Iceteavanill/MicroManipulatorStepper/electronics/control_board/production/ControlBoard_v1.csv

Reference | Qty | Value | Footprint | Datasheet | Distributor | Distributor Number
A1 | 1 | RaspberryPi_Pico | Module:RaspberryPi_Pico_Common_Unspecified | https://datasheets.raspberrypi.com/pico/pico-datasheet.pdf | Digikey | 2648-SC0918CT-ND
C1,C7-C10,C14-C17,C21-C24 | 13 | 0.1u | Capacitor_SMD:C_0603_1608Metric_Pad1.08x0.95mm_HandSolder |  | Digikey | 399-C0603C104M5RACTUCT-ND
C2-C4 | 3 | 22u | Capacitor_SMD:C_0805_2012Metric_Pad1.18x1.45mm_HandSolder |  | Digikey | 490-10749-1-ND
C5 | 1 | 1u | Capacitor_SMD:C_0805_2012Metric_Pad1.18x1.45mm_HandSolder |  | Digikey | 1276-6469-1-ND
C6,C11,C13,C18,C20,C25 | 6 | 10u | Capacitor_SMD:C_0805_2012Metric_Pad1.18x1.45mm_HandSolder |  | Digikey | 490-10502-1-ND
C12,C19,C26 | 3 | 100u | Capacitor_THT:CP_Radial_D6.3mm_P2.50mm |  | Digikey | 399-A7C0EB107M1EAAS065-ND
D1 | 1 | 1N5819 | Diode_THT:D_DO-41_SOD81_P10.16mm_Horizontal | http://www.vishay.com/docs/88525/1n5817.pdf | Digikey | 1801-1N5819CT-ND
D2 | 1 | PMEG4010 | Diode_SMD:D_SOD-123F | https://assets.nexperia.com/documents/data-sheet/PMEG4010CEH_PMEG4010CEJ.pdf | Digikey | -
D3 | 1 | SMAJ12CA | Diode_SMD:D_SMA_Handsoldering | https://www.diodes.com/assets/Datasheets/SMAJ5.0CA-SMAJ200CA.pdf | Digikey | SMAJ12CALFCT-ND
D4 | 1 | 12V_OK | LED_SMD:LED_0805_2012Metric_Pad1.15x1.40mm_HandSolder |  | ? | -
D5 | 1 | 5V_OK | LED_SMD:LED_0805_2012Metric_Pad1.15x1.40mm_HandSolder |  | ? | -
D6 | 1 | 3V3_OK | LED_SMD:LED_0805_2012Metric_Pad1.15x1.40mm_HandSolder |  | ? | -
F1 | 1 | 7A | Fuse:Fuse_1206_3216Metric_Pad1.42x1.75mm_HandSolder |  | Digikey | 5923-0685T7000-01CT-ND
J1 | 1 | Power | Connector_AMASS:AMASS_XT60-M_1x02_P7.20mm_Vertical |  | Digikey | 1738-1437-ND
J2,J4,J5 | 3 | Conn_01x06_Pin | Connector_JST:JST_PH_B6B-PH-K_1x06_P2.00mm_Vertical |  | Digikey | 455-B6B-XH-A-ND
J3 | 1 | Barrel_Jack_Switch | Connector_BarrelJack:BarrelJack_Horizontal |  | Digikey | 839-54-00166-ND
J6 | 1 | I2C | Connector_JST:JST_PH_B4B-PH-K_1x04_P2.00mm_Vertical |  | Digikey | 455-B4B-XH-A-ND
J7-J11 | 5 | Conn_01x02_Pin | Connector_PinHeader_2.54mm:PinHeader_1x02_P2.54mm_Vertical |  | Digikey | 455-B2B-XH-A-ND
J12-J14 | 3 |  | Connector_PinHeader_2.54mm:PinHeader_1x04_P2.54mm_Vertical |  | Digikey | 455-B4B-XH-A-ND
R2-R7,R10 | 7 | 4k7 | Resistor_SMD:R_0603_1608Metric_Pad0.98x0.95mm_HandSolder |  | Digikey | 541-4.70KHCT-ND
R8,R9 | 2 | 1k | Resistor_SMD:R_0603_1608Metric_Pad0.98x0.95mm_HandSolder |  | Digikey | 541-1.00KHCT-ND
U1 | 1 | DCDC_Converter | DCDC_Converter:DCDC_17mmx12mm |  | ? | -
U2 | 1 | TPSM33610S5QRDNRQ1 | Additions:TPSM33610S5QRDNRQ1 | https://www.ti.com/lit/ds/symlink/tpsm33610-q1.pdf?ts=1782474547448 | Digikey | 296-TPSM33620S5QRDNRQ1CT-ND
U3-U5 | 3 | TB6612FNG | Package_SO:SSOP-24_5.3x8.2mm_P0.65mm | https://toshiba.semicon-storage.com/us/product/linear/motordriver/detail.TB6612FNG.html | Digikey | TB6612FNGC8ELCT-ND
