Iceteavanill/MicroManipulatorStepper/electronics/control_board/production/ControlBoard_v1.4.pdf

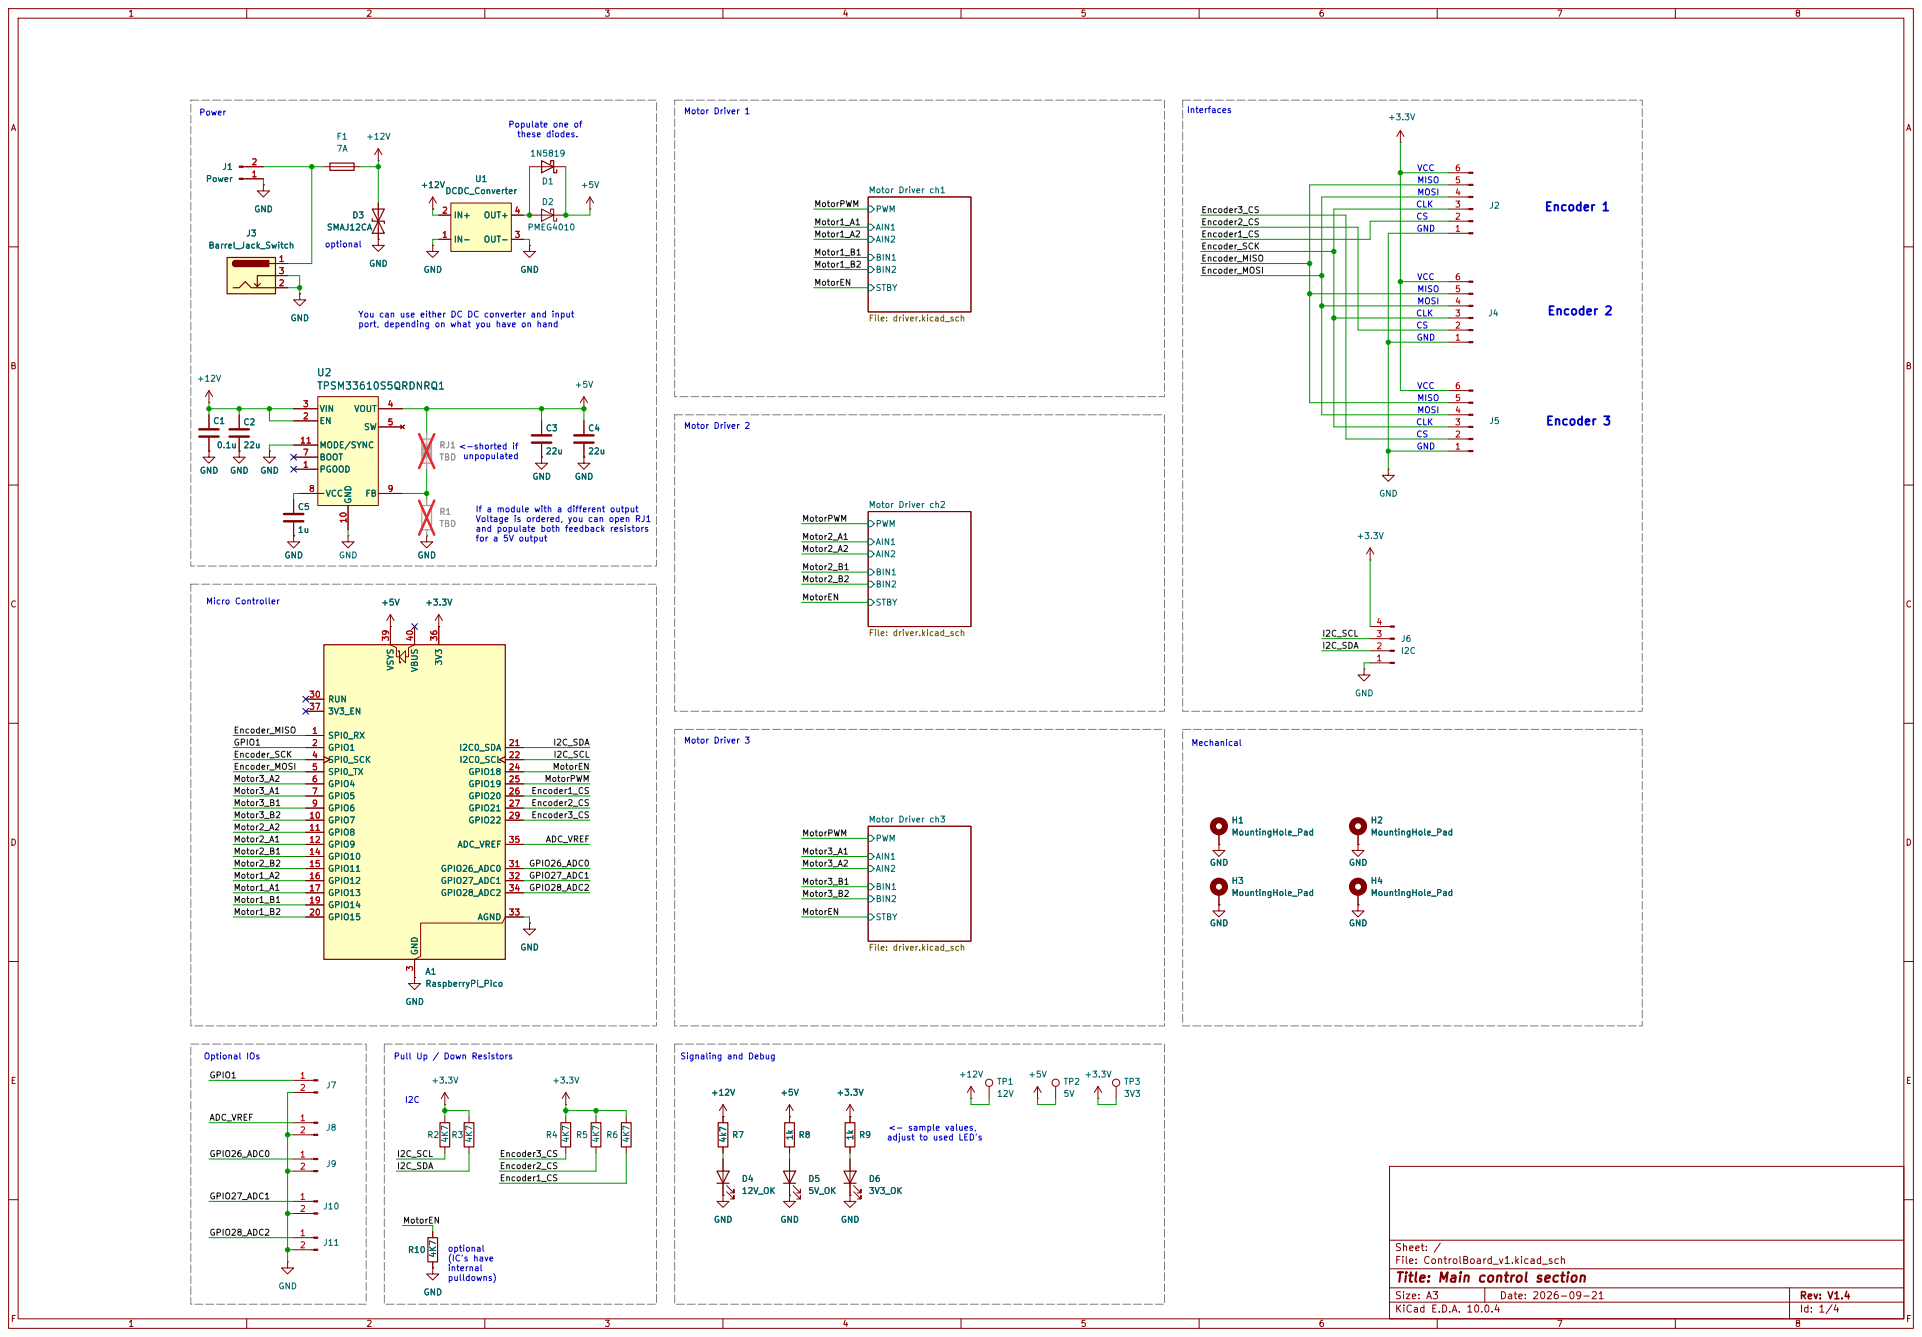
[picture p1: page 1]

You can use either DC DC converter and input
VCC 8 U2
TPSM33610S5QRDNRQ1

port, depending on what you have on hand Micro Controller

for a 5V output <-shorted if unpopulated
TBD

If a module with a different output
Voltage is ordered, you can open RJ1 and populate both feedback resistors

Pull Up / Down Resistors
ADC_VREF GPIO1 GPIO27_ADC1 GPIO28_ADC2

adjust to used LED's optional

Sheet: /
File: ControlBoard_v1.kicad_sch
Title: Main control section

Size: A3 | Rev: V1.4
KiCad E.D.A. 10.0.4 | Id: 1/4

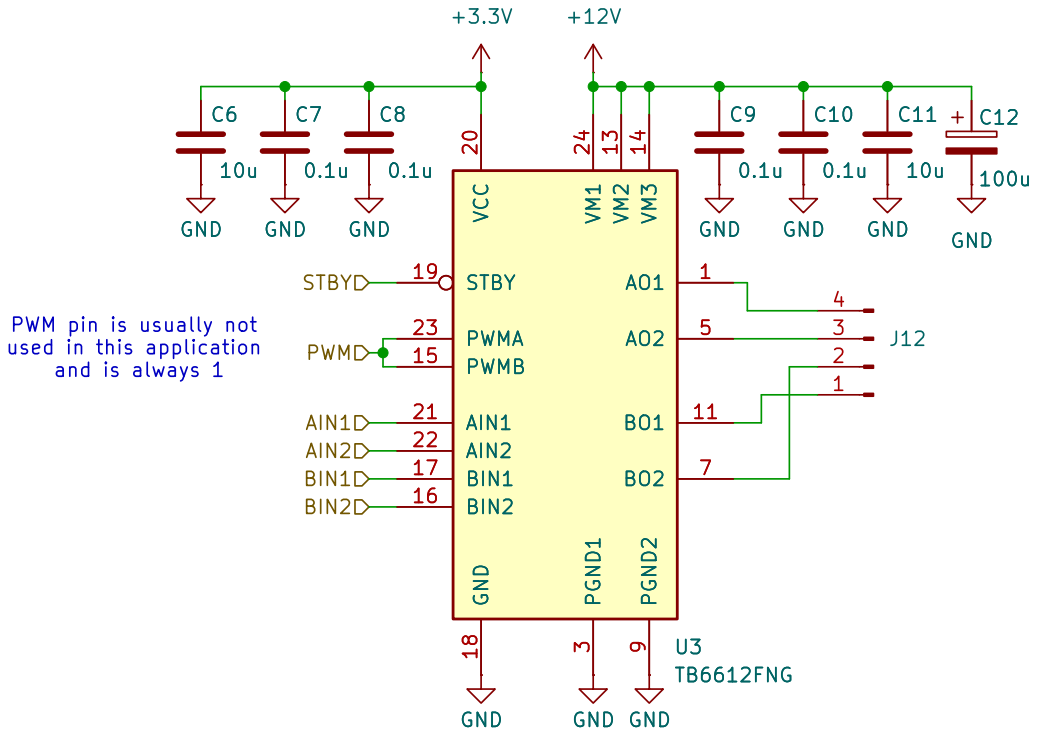
[picture p2: page 2]

and is always 1 GND

BIN2 PWM pin is usually not used in this application

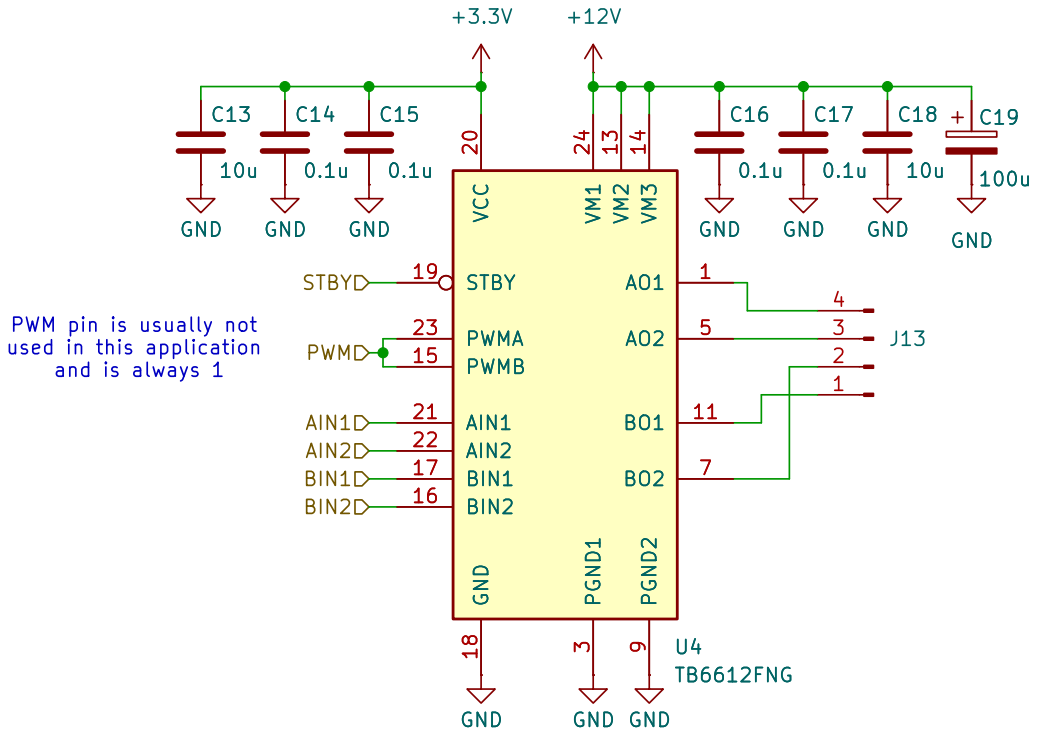
[picture p3: page 3]

and is always 1 GND

BIN2 PWM pin is usually not used in this application

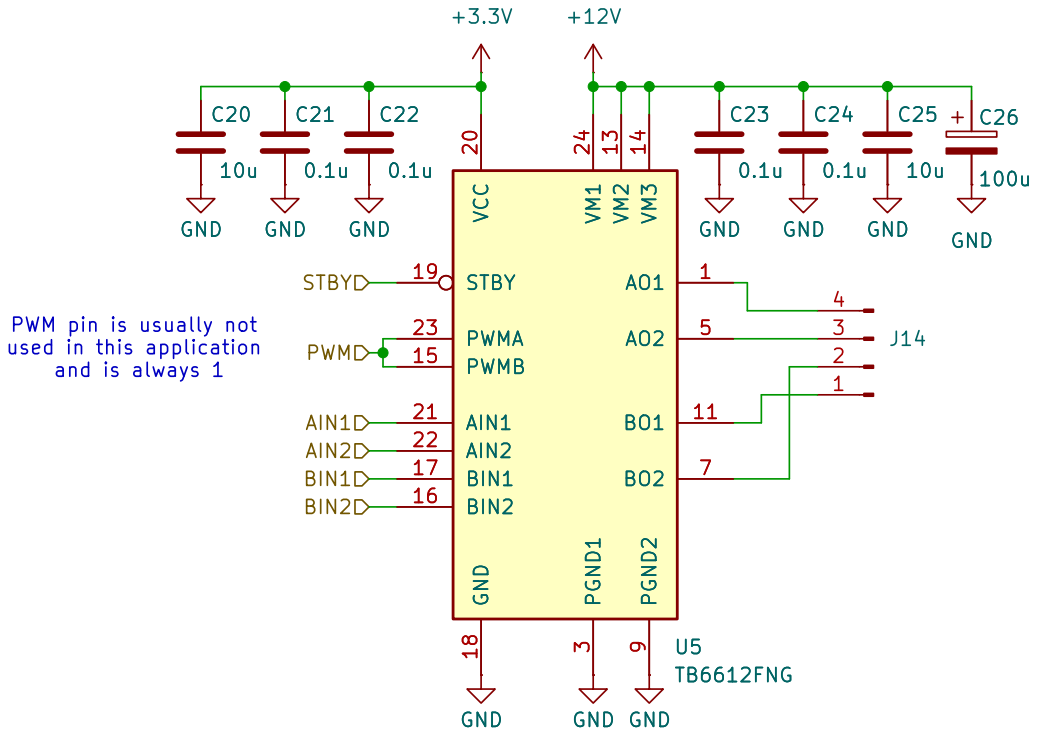
[picture p4: page 4]

and is always 1 GND

BIN2 PWM pin is usually not used in this application
