Iceteavanill/MicroManipulatorStepper/electronics/control_board/ControlBoard_v1.kicad_pcb

## KiCad design electronics/control_board/ControlBoard_v1.kicad_pcb (2026-10-14)

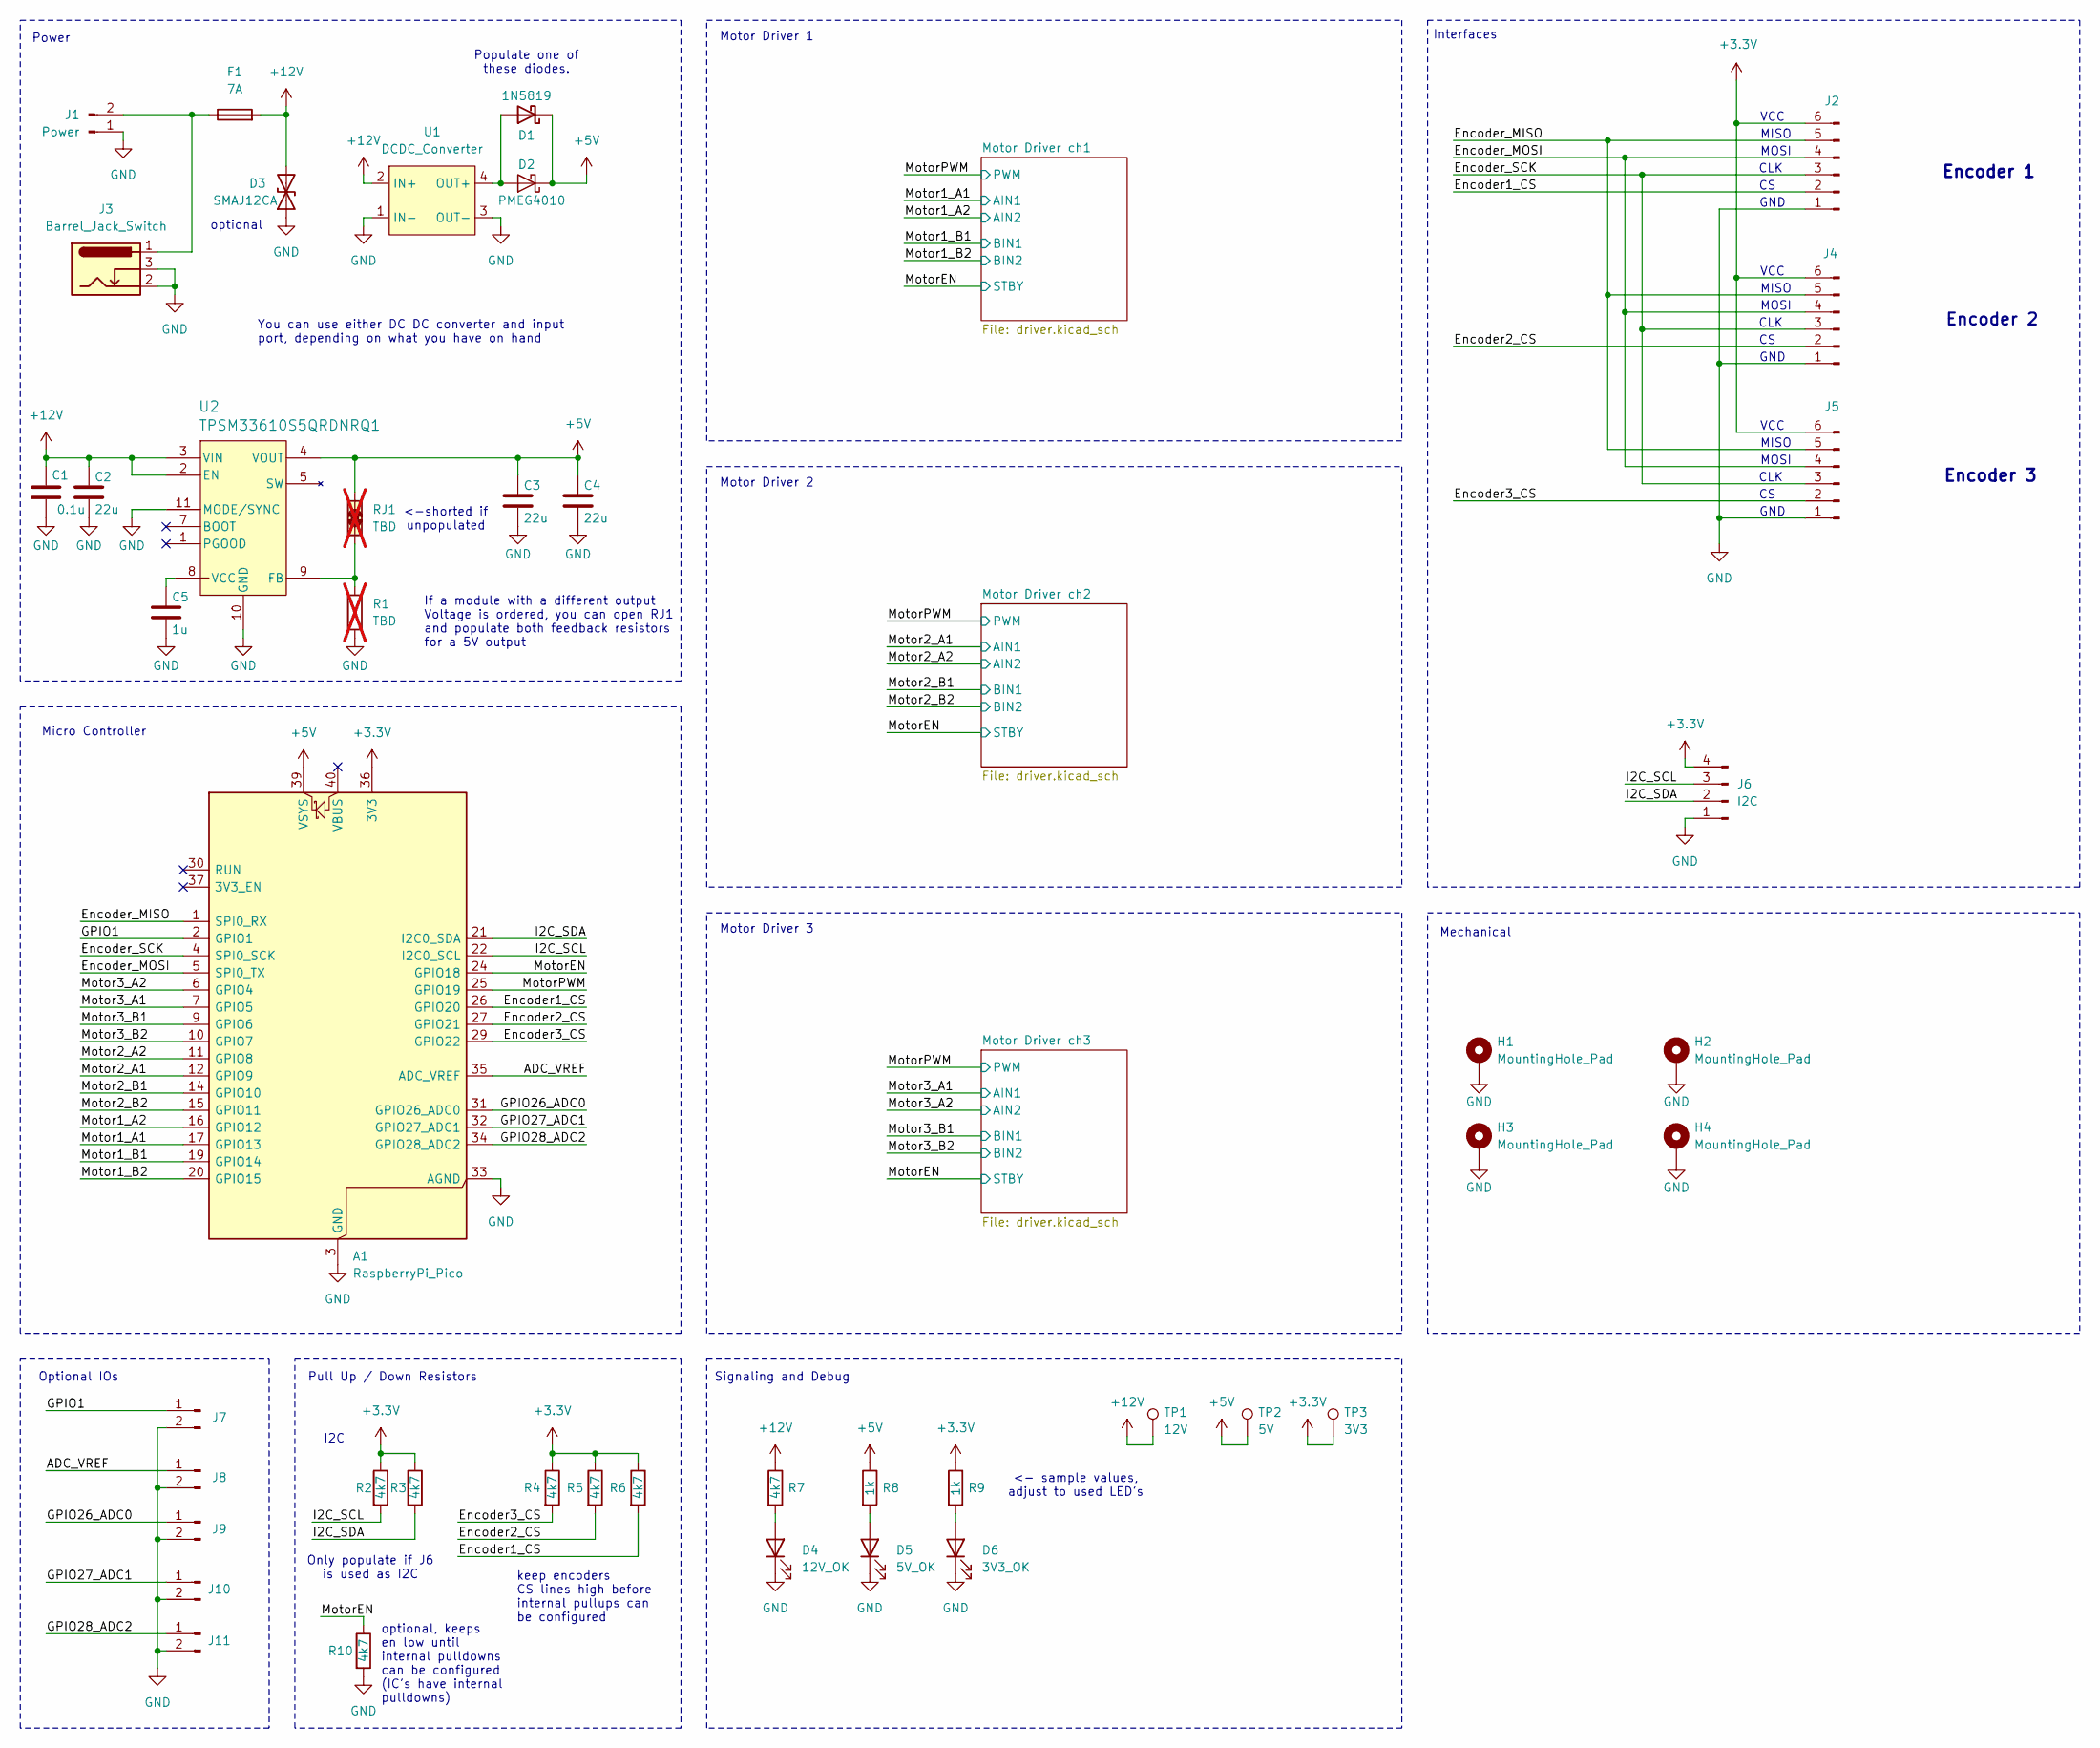
[picture p5: schematic ControlBoard_v1.kicad_sch, Main control section]

Parts:
A1: RaspberryPi_Pico; RaspberryPi_Pico_Common_Unspecified
C1: 0.1u; C_0603_1608Metric_Pad1.08x0.95mm_HandSolder
C2, C3, C4: 22u; C_0805_2012Metric_Pad1.18x1.45mm_HandSolder
C5: 1u; C_0805_2012Metric_Pad1.18x1.45mm_HandSolder
D1: 1N5819; D_DO-41_SOD81_P10.16mm_Horizontal
D2: PMEG4010; D_SOD-123F
D3: SMAJ12CA; D_SMA_Handsoldering
D4: 12V_OK; LED_0805_2012Metric_Pad1.15x1.40mm_HandSolder
D5: 5V_OK; LED_0805_2012Metric_Pad1.15x1.40mm_HandSolder
D6: 3V3_OK; LED_0805_2012Metric_Pad1.15x1.40mm_HandSolder
F1: 7A; Fuse_1206_3216Metric_Pad1.42x1.75mm_HandSolder
H1, H2, H3, H4: MountingHole_Pad; MountingHole_2.7mm_M2.5_Pad_Via
J1: Power; AMASS_XT60-M_1x02_P7.20mm_Vertical
J2, J4, J5: Conn_01x06_Pin; JST_PH_B6B-PH-K_1x06_P2.00mm_Vertical
J3: Barrel_Jack_Switch; BarrelJack_Horizontal
J6: I2C; JST_PH_B4B-PH-K_1x04_P2.00mm_Vertical
J7, J8, J9, J10, J11: Conn_01x02_Pin; PinHeader_1x02_P2.54mm_Vertical
R1: TBD; R_0603_1608Metric_Pad0.98x0.95mm_HandSolder; not fitted
R2, R3, R4, R5, R6, R7, R10: 4k7; R_0603_1608Metric_Pad0.98x0.95mm_HandSolder
R8, R9: 1k; R_0603_1608Metric_Pad0.98x0.95mm_HandSolder
RJ1: TBD; 0603_shorted_resistor; not fitted
TP1: 12V; TestPoint_Pad_D2.0mm
TP2: 5V; TestPoint_Pad_D2.0mm
TP3: 3V3; TestPoint_Pad_D2.0mm
U1: DCDC_Converter; DCDC_17mmx12mm
U2: TPSM33610S5QRDNRQ1

Connections:
+3.3V: A1.36 (3V3), J2.6, J4.6, J5.6, J6.4, R2.1, R3.1, R4.1, R5.1, R6.1, R9.1, TP3.1 (1_1); also elsewhere on the board
+5V: A1.39 (VSYS), C3.1, C4.1, D1.1 (K), D2.1 (K), R8.1, RJ1.1, TP2.1 (1_1), U2.4 (VOUT)
+12V: C1.1, C2.1, D3.2 (A2), F1.2, R7.1, TP1.1 (1_1), U1.2 (IN+), U2.2 (EN), U2.3 (VIN); also elsewhere on the board
/ADC_VREF: A1.35 (ADC_VREF), J8.1
/Encoder1_CS: A1.26 (GPIO20), J2.2, R6.2
/Encoder2_CS: A1.27 (GPIO21), J4.2, R5.2
/Encoder3_CS: A1.29 (GPIO22), J5.2, R4.2
/Encoder_MISO: A1.1 (SPI0_RX), J2.5, J4.5, J5.5
/Encoder_MOSI: A1.5 (SPI0_TX), J2.4, J4.4, J5.4
/Encoder_SCK: A1.4 (SPI0_SCK), J2.3, J4.3, J5.3
/GPIO1: A1.2 (GPIO1), J7.1
/GPIO26_ADC0: A1.31 (GPIO26_ADC0), J9.1
/GPIO27_ADC1: A1.32 (GPIO27_ADC1), J10.1
/GPIO28_ADC2: A1.34 (GPIO28_ADC2), J11.1
/I2C_SCL: A1.22 (I2C0_SCL), J6.3, R2.2
/I2C_SDA: A1.21 (I2C0_SDA), J6.2, R3.2
/Motor1_A1: A1.17 (GPIO13); also elsewhere on the board
/Motor1_A2: A1.16 (GPIO12); also elsewhere on the board
/Motor1_B1: A1.19 (GPIO14); also elsewhere on the board
/Motor1_B2: A1.20 (GPIO15); also elsewhere on the board
/Motor2_A1: A1.12 (GPIO9); also elsewhere on the board
/Motor2_A2: A1.11 (GPIO8); also elsewhere on the board
/Motor2_B1: A1.14 (GPIO10); also elsewhere on the board
/Motor2_B2: A1.15 (GPIO11); also elsewhere on the board
/Motor3_A1: A1.7 (GPIO5); also elsewhere on the board
/Motor3_A2: A1.6 (GPIO4); also elsewhere on the board
/Motor3_B1: A1.9 (GPIO6); also elsewhere on the board
/Motor3_B2: A1.10 (GPIO7); also elsewhere on the board
/MotorEN: A1.24 (GPIO18), R10.1; also elsewhere on the board
/MotorPWM: A1.25 (GPIO19); also elsewhere on the board
GND: A1.3 (GND), A1.8 (GND), A1.13 (GND), A1.18 (GND), A1.23 (GND), A1.28 (GND), A1.33 (AGND), A1.38 (GND), C1.2, C2.2, C3.2, C4.2, C5.2, D3.1 (A1), D4.1 (K), D5.1 (K), D6.1 (K), H1.1 (1_1), H2.1 (1_1), H3.1 (1_1), H4.1 (1_1), J1.1, J2.1, J3.2, J3.3, J4.1, J5.1, J6.1, J7.2, J8.2, J9.2, J10.2, J11.2, R1.2, R10.2, U1.1 (IN-), U1.3 (OUT-), U2.10 (GND), U2.11 (MODE/SYNC); also elsewhere on the board
unnamed: D1.2 (A), D2.2 (A), U1.4 (OUT+)
unnamed: D4.2 (A), R7.2
unnamed: D5.2 (A), R8.2
unnamed: D6.2 (A), R9.2
unnamed: F1.1, J1.2, J3.1
unnamed: R1.1, RJ1.2, U2.9 (FB)
unnamed: C5.1, U2.8 (VCC)

Notes on the sheet:
<- sample values, adjust to used LED's
Only populate if J6 is used as I2C
Encoder 2
<-shorted if unpopulated
keep encoders CS lines high before internal pullups can be configured
Encoder 3
Optional IOs
If a module with a different output Voltage is ordered, you can open RJ1 and populate both feedback resistors for a 5V output
MOSI
Power
MISO
VCC
GND
Motor Driver 2
CLK
optional, keeps en low until internal pulldowns can be configured (IC's have internal pulldowns)
You can use either DC DC converter and input port, depending on what you have on hand
Interfaces
Motor Driver 1
I2C
Encoder 1
optional
Pull Up / Down Resistors
Mechanical
Motor Driver 3
Populate one of these diodes.
Signaling and Debug
Micro Controller

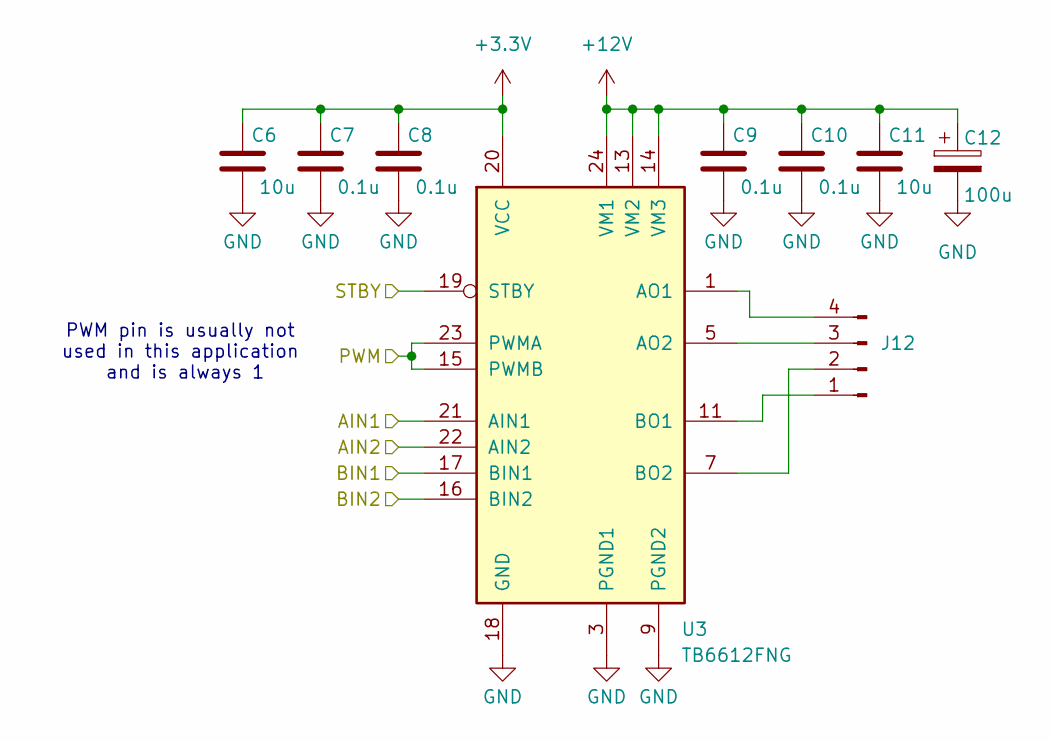
[picture p6: schematic driver.kicad_sch, Motor driver]

Parts:
C6, C11: 10u; C_0805_2012Metric_Pad1.18x1.45mm_HandSolder
C7, C8, C9, C10: 0.1u; C_0603_1608Metric_Pad1.08x0.95mm_HandSolder
C12: 100u; CP_Radial_D6.3mm_P2.50mm
J12: PinHeader_1x04_P2.54mm_Vertical
U3: TB6612FNG; SSOP-24_5.3x8.2mm_P0.65mm

Connections:
+3.3V: C6.1, C7.1, C8.1, U3.20 (VCC); also elsewhere on the board
+12V: C9.1, C10.1, C11.1, C12.1, U3.13 (VM2), U3.14 (VM3), U3.24 (VM1); also elsewhere on the board
/Motor1_A1: U3.21 (AIN1); also elsewhere on the board
/Motor1_A2: U3.22 (AIN2); also elsewhere on the board
/Motor1_B1: U3.17 (BIN1); also elsewhere on the board
/Motor1_B2: U3.16 (BIN2); also elsewhere on the board
/MotorEN: U3.19 (STBY); also elsewhere on the board
/MotorPWM: U3.15 (PWMB), U3.23 (PWMA); also elsewhere on the board
GND: C6.2, C7.2, C8.2, C9.2, C10.2, C11.2, C12.2, U3.3 (PGND1), U3.4 (PGND1), U3.9 (PGND2), U3.10 (PGND2), U3.18 (GND); also elsewhere on the board
unnamed: J12.1, U3.11 (BO1), U3.12 (BO1)
unnamed: J12.2, U3.7 (BO2), U3.8 (BO2)
unnamed: J12.3, U3.5 (AO2), U3.6 (AO2)
unnamed: J12.4, U3.1 (AO1), U3.2 (AO1)

Parts of its further copies:
C13, C18, C20, C25: 10u; C_0805_2012Metric_Pad1.18x1.45mm_HandSolder
C14, C15, C16, C17, C21, C22, C23, C24: 0.1u; C_0603_1608Metric_Pad1.08x0.95mm_HandSolder
C19, C26: 100u; CP_Radial_D6.3mm_P2.50mm
U4, U5: TB6612FNG; SSOP-24_5.3x8.2mm_P0.65mm

Connections of its further copies:
+3.3V: C13.1, C14.1, C15.1, C20.1, C21.1, C22.1, U4.20 (VCC), U5.20 (VCC); also elsewhere on the board
+12V: C16.1, C17.1, C18.1, C19.1, C23.1, C24.1, C25.1, C26.1, U4.13 (VM2), U4.14 (VM3), U4.24 (VM1), U5.13 (VM2), U5.14 (VM3), U5.24 (VM1); also elsewhere on the board
/Motor2_A1: U4.21 (AIN1); also elsewhere on the board
/Motor2_A2: U4.22 (AIN2); also elsewhere on the board
/Motor2_B1: U4.17 (BIN1); also elsewhere on the board
/Motor2_B2: U4.16 (BIN2); also elsewhere on the board
/Motor3_A1: U5.21 (AIN1); also elsewhere on the board
/Motor3_A2: U5.22 (AIN2); also elsewhere on the board
/Motor3_B1: U5.17 (BIN1); also elsewhere on the board
/Motor3_B2: U5.16 (BIN2); also elsewhere on the board
/MotorEN: U4.19 (STBY), U5.19 (STBY); also elsewhere on the board
/MotorPWM: U4.15 (PWMB), U4.23 (PWMA), U5.15 (PWMB), U5.23 (PWMA); also elsewhere on the board
GND: C13.2, C14.2, C15.2, C16.2, C17.2, C18.2, C19.2, C20.2, C21.2, C22.2, C23.2, C24.2, C25.2, C26.2, U4.3 (PGND1), U4.4 (PGND1), U4.9 (PGND2), U4.10 (PGND2), U4.18 (GND), U5.3 (PGND1), U5.4 (PGND1), U5.9 (PGND2), U5.10 (PGND2), U5.18 (GND); also elsewhere on the board
unnamed 40: U4.11 (BO1), U4.12 (BO1); also elsewhere on the board
unnamed 41: U4.7 (BO2), U4.8 (BO2); also elsewhere on the board
unnamed 42: U4.5 (AO2), U4.6 (AO2); also elsewhere on the board
unnamed 43: U4.1 (AO1), U4.2 (AO1); also elsewhere on the board
unnamed 44: U5.11 (BO1), U5.12 (BO1); also elsewhere on the board
unnamed 45: U5.7 (BO2), U5.8 (BO2); also elsewhere on the board
unnamed 46: U5.5 (AO2), U5.6 (AO2); also elsewhere on the board
unnamed 47: U5.1 (AO1), U5.2 (AO1); also elsewhere on the board

Notes on the sheet:
PWM pin is usually not used in this application and is always 1

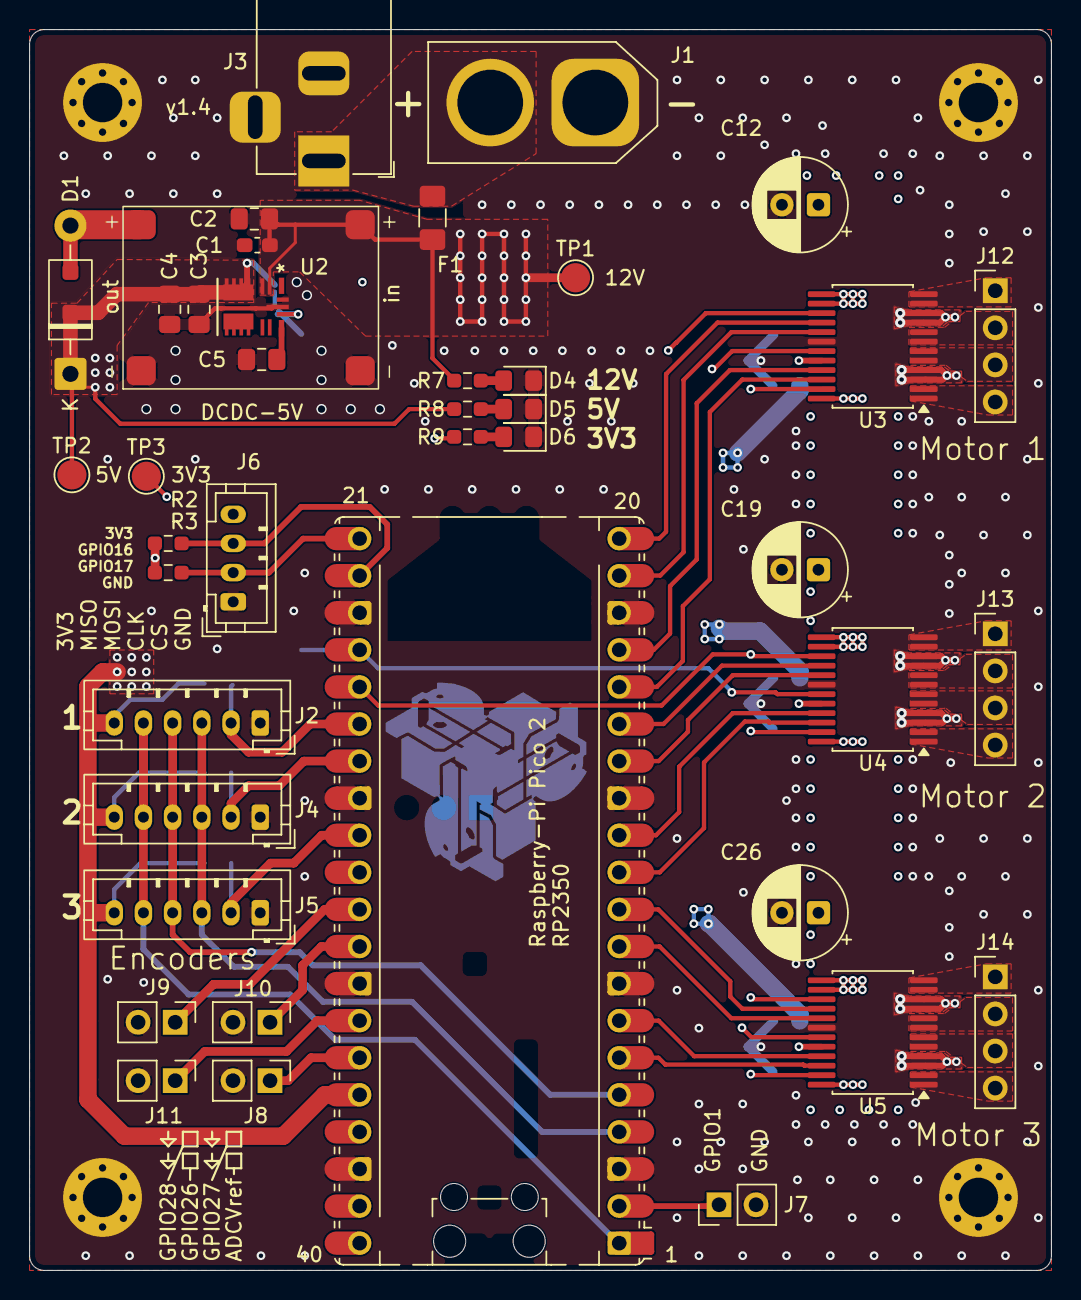
[picture p7: board ControlBoard_v1.kicad_pcb from above]

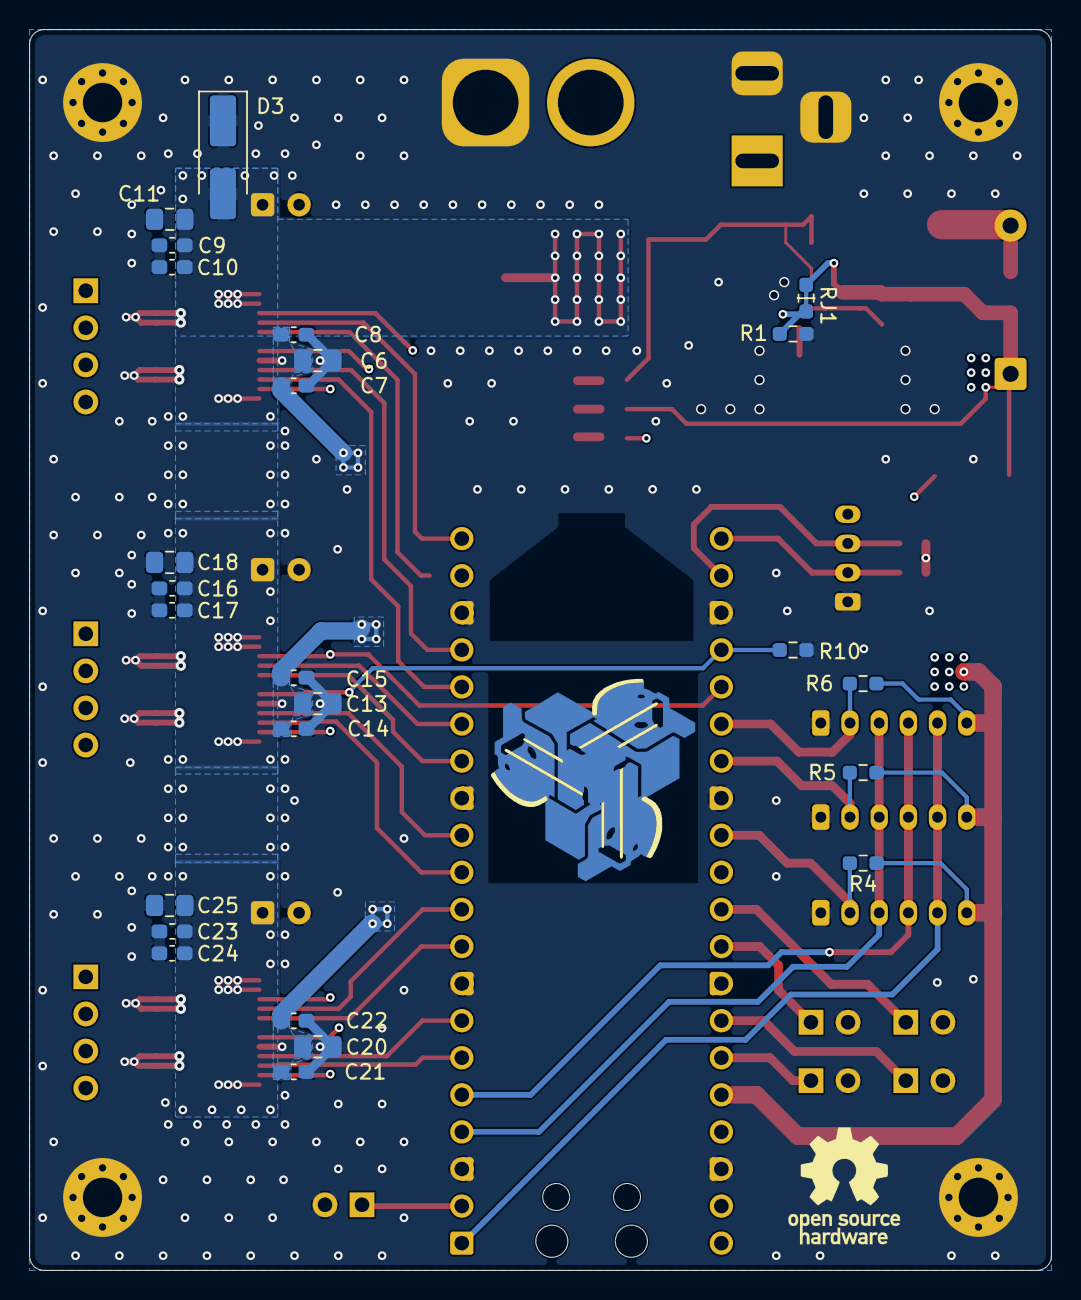
[picture p8: board ControlBoard_v1.kicad_pcb from below]

Board: 4 copper layers, 70.0 x 85.0 mm, 71 parts (26 on the bottom side), 50 nets.

Other parts of the board:
J13, J14: PinHeader_1x04_P2.54mm_Vertical

Their connections:
unnamed 40: J13.1; also elsewhere on the board
unnamed 41: J13.2; also elsewhere on the board
unnamed 42: J13.3; also elsewhere on the board
unnamed 43: J13.4; also elsewhere on the board
unnamed 44: J14.1; also elsewhere on the board
unnamed 45: J14.2; also elsewhere on the board
unnamed 46: J14.3; also elsewhere on the board
unnamed 47: J14.4; also elsewhere on the board
