Iceteavanill/MicroManipulatorStepper/(commit log)

2026-09-21 removed Encoder Board because it is now integrated in the main PCB
    [EncoderBoard.kicad_pcb, EncoderBoard.kicad_sch]
2026-09-23 Worked on PCB (moved to 4 layers)
    [ControlBoard_v1.kicad_pcb, ControlBoard_v1.kicad_sch, driver.kicad_sch]
2026-09-23 Worked on schematic and layout Added logo
    [ControlBoard_v1.kicad_pcb, ControlBoard_v1.kicad_sch, driver.kicad_sch]
2026-10-03 Worked on PCB and Schematic, created production files
2026-10-16 Configured the drivers for a lower current value fixed lockout bug that made the storing of files impossible Added M54 to serve as a position readout
